defuseme/DefuseMe/doc/module/BigSwitch_4Lamps.docx

Big Switch – 4 Lamps

The module consists of a 3-position switch and
4 lamps lighting in orange and pink

Follow the flow chart:
The question rhomb asks if the specified lamp is lit.
The corresponding action box shows to which position the switch has to be rotated.

If all goes wrong, switch to position ‘0’ and start from top!

Lamps:
L-Pk = Left Pink Lamp
L-Or = Left Orange Lamp
R-Pk = Right Pink Lamp
R-Or = Right Orange Lamp
Switch: Note: switching fast
L = Left Pos. CCW from L->R or R->L
0 = Middle Pos. Don’t pause on ‘0’
R = Right Pos. CW

Defuseme.org BS4L V0.2 - JK
