defuseme/DefuseMe/module/BlueButtonStripe/design.ods

Sheet: snocode
Serial number digits |  |  |  | Number of BLUE BLINKING LEDs
1st | 2nd | 3rd | 4th to 15th | 0 | 1 | 2 | 3 | 4 | 5 | 6 | 7 | 8 | 9 | 10 | 11 | 12 | 13 | 14 | 15 | 16 | 17 | 18 | 19 | 20 | 21 | 22
0 | 0 | n.a. |  | 61 | 68 | 75 | 82 | 89 | 96 | 3 | 10 | 17 | 24 | 31 | 38 | 45 | 52 | 59 | 66 | 73 | 80 | 87 | 94 | 1 | 8 | 15 | 0
0 | 1 | n.a. |  | 85 | 92 | 99 | 6 | 13 | 20 | 27 | 34 | 41 | 48 | 55 | 62 | 69 | 76 | 83 | 90 | 97 | 4 | 11 | 18 | 25 | 32 | 39 | 1
0 | 2 | n.a. |  | 9 | 16 | 23 | 30 | 37 | 44 | 51 | 58 | 65 | 72 | 79 | 86 | 93 | 0 | 7 | 14 | 21 | 28 | 35 | 42 | 49 | 56 | 63 | 2
0 | 3 | n.a. |  | 33 | 40 | 47 | 54 | 61 | 68 | 75 | 82 | 89 | 96 | 3 | 10 | 17 | 24 | 31 | 38 | 45 | 52 | 59 | 66 | 73 | 80 | 87 | 3
0 | 4…7 | 0 | n.a. | 57 | 64 | 71 | 78 | 85 | 92 | 99 | 6 | 13 | 20 | 27 | 34 | 41 | 48 | 55 | 62 | 69 | 76 | 83 | 90 | 97 | 4 | 11 | 4
0 | 4…7 | not 0 | n.a. | 81 | 88 | 95 | 2 | 9 | 16 | 23 | 30 | 37 | 44 | 51 | 58 | 65 | 72 | 79 | 86 | 93 | 0 | 7 | 14 | 21 | 28 | 35 | 5
0 | 8…9 | n.a. |  | 5 | 12 | 19 | 26 | 33 | 40 | 47 | 54 | 61 | 68 | 75 | 82 | 89 | 96 | 3 | 10 | 17 | 24 | 31 | 38 | 45 | 52 | 59 | 6
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
