defuseme/DefuseMe/module/BigSwitch4Lamps/BigSwitchDesign.xlsx

Sheet: Design
Path | Step | L-Pk | L-Or | R-Pk | R-Or | Switch-L | Switch-R
0 | 0 |  | 1 |  | 1 | 1 |  | // 0
 | 1 |  | 1 | 1 |  |  | 1
 | 2 | 1 |  | 1
 | 3 |  | 1 |  | 1 | 1
 | 4 | 1 | 0 | 1 | 1 |  | 1
 | 5 | 0 | 1 | 1 |  | 0 | 0
 | 6
 | 7
 | 8
 | 9
1 | 0 |  | 1 |  | 1 | 1 |  | // 1
 | 1 | 1 |  | 0 | 1
 | 2 | 0 | 1 |  | 1 |  | 1
 | 3 | 0 | 1 | 1
 | 4 | 1 | 0 | 1 |  |  | 1
 | 5 | 0 | 1 | 1 |  | 0 | 0
 | 6
 | 7
 | 8
 | 9
2 | 0 |  | 1 | 1 |  | 1 |  | // 2
 | 1 |  | 1 | 0 | 1
 | 2 | 1 |  |  | 1 | 1
 | 3 | 1 |  | 1 | 0
 | 4 |  | 1 | 1 | 0 | 1
 | 5 | 0 | 1 |  | 1 |  | 1
 | 6 | 0 | 1 | 1 |  | 0 | 0
 | 7
 | 8
 | 9
3 | 0 | 1 | 0 | 1 |  |  | 1 | // 3
 | 1 |  | 1 | 1 | 0 | 1
 | 2 |  | 1 |  | 1 |  | 1
 | 3 | 1 | 0 |  | 1 | 1
 | 4 | 1 |  | 1
 | 5 |  | 1 | 1 | 0 | 1
 | 6 | 0 | 1 |  | 1 |  | 1
 | 7 | 0 | 1 | 1 |  | 0 | 0
 | 8
 | 9
4 | 0 |  | 1 | 1 |  | 1 |  | // 4
 | 1 |  | 1 | 0 | 1
 | 2 | 0 | 1 | 1 |  |  | 1
 | 3 | 1 |  | 1 |  | 1
 | 4 |  | 1 | 1 | 0
 | 5 | 1 | 0 | 1 |  |  | 1
 | 6 | 0 | 1 | 1 |  | 0 | 0
 | 7
 | 8
 | 9
5 | 0 |  | 1 |  | 1 | 1 |  | // 5
 | 1 |  | 1 | 1 |  |  | 1
 | 2 |  | 1 | 0 | 1 | 1
 | 3 | 1 |  |  | 1
 | 4 | 1 |  | 1 | 0 | 1
 | 5 | 0 | 1 | 1 |  |  | 1
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
