defuseme/DefuseMe/doc/module/ModuleScematics.pdf

# Overview

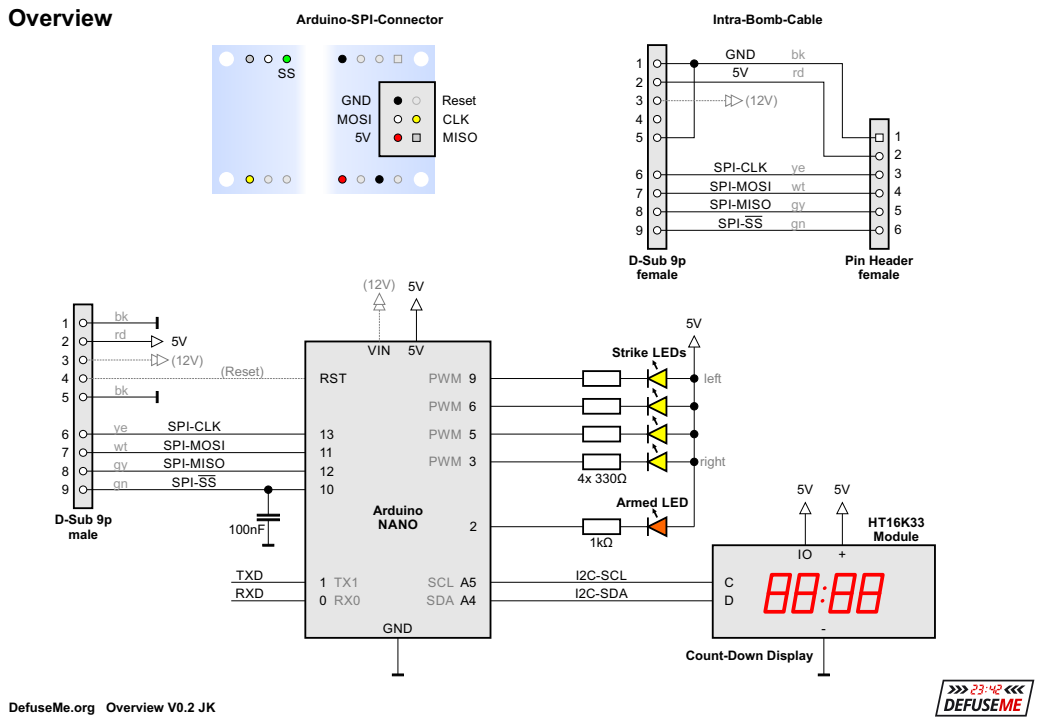
[picture p4: page 1]
SPI-SS; SPI-MISO; SPI-MOSI; SPI-CLK; RXD; TXD; I2C-SDA; I2C-SCL; SCL A5 SDA A4; GND; Arduino NANO; D-Sub 9p male; PWM 3; PWM 5; PWM 6; PWM 9; HT16K33 Module; Armed LED; VIN; MISO; CLK; MOSI; Reset; (Reset); D-Sub 9p female; Pin Header female; RST; Arduino-SPI-Connector; Intra-Bomb-Cable; Strike LEDs; left; right

Count-Down Display

DefuseMe.org Overview V0.2 JK
