defuseme/DefuseMe/lasercutter/Bomb01Combi2.pdf

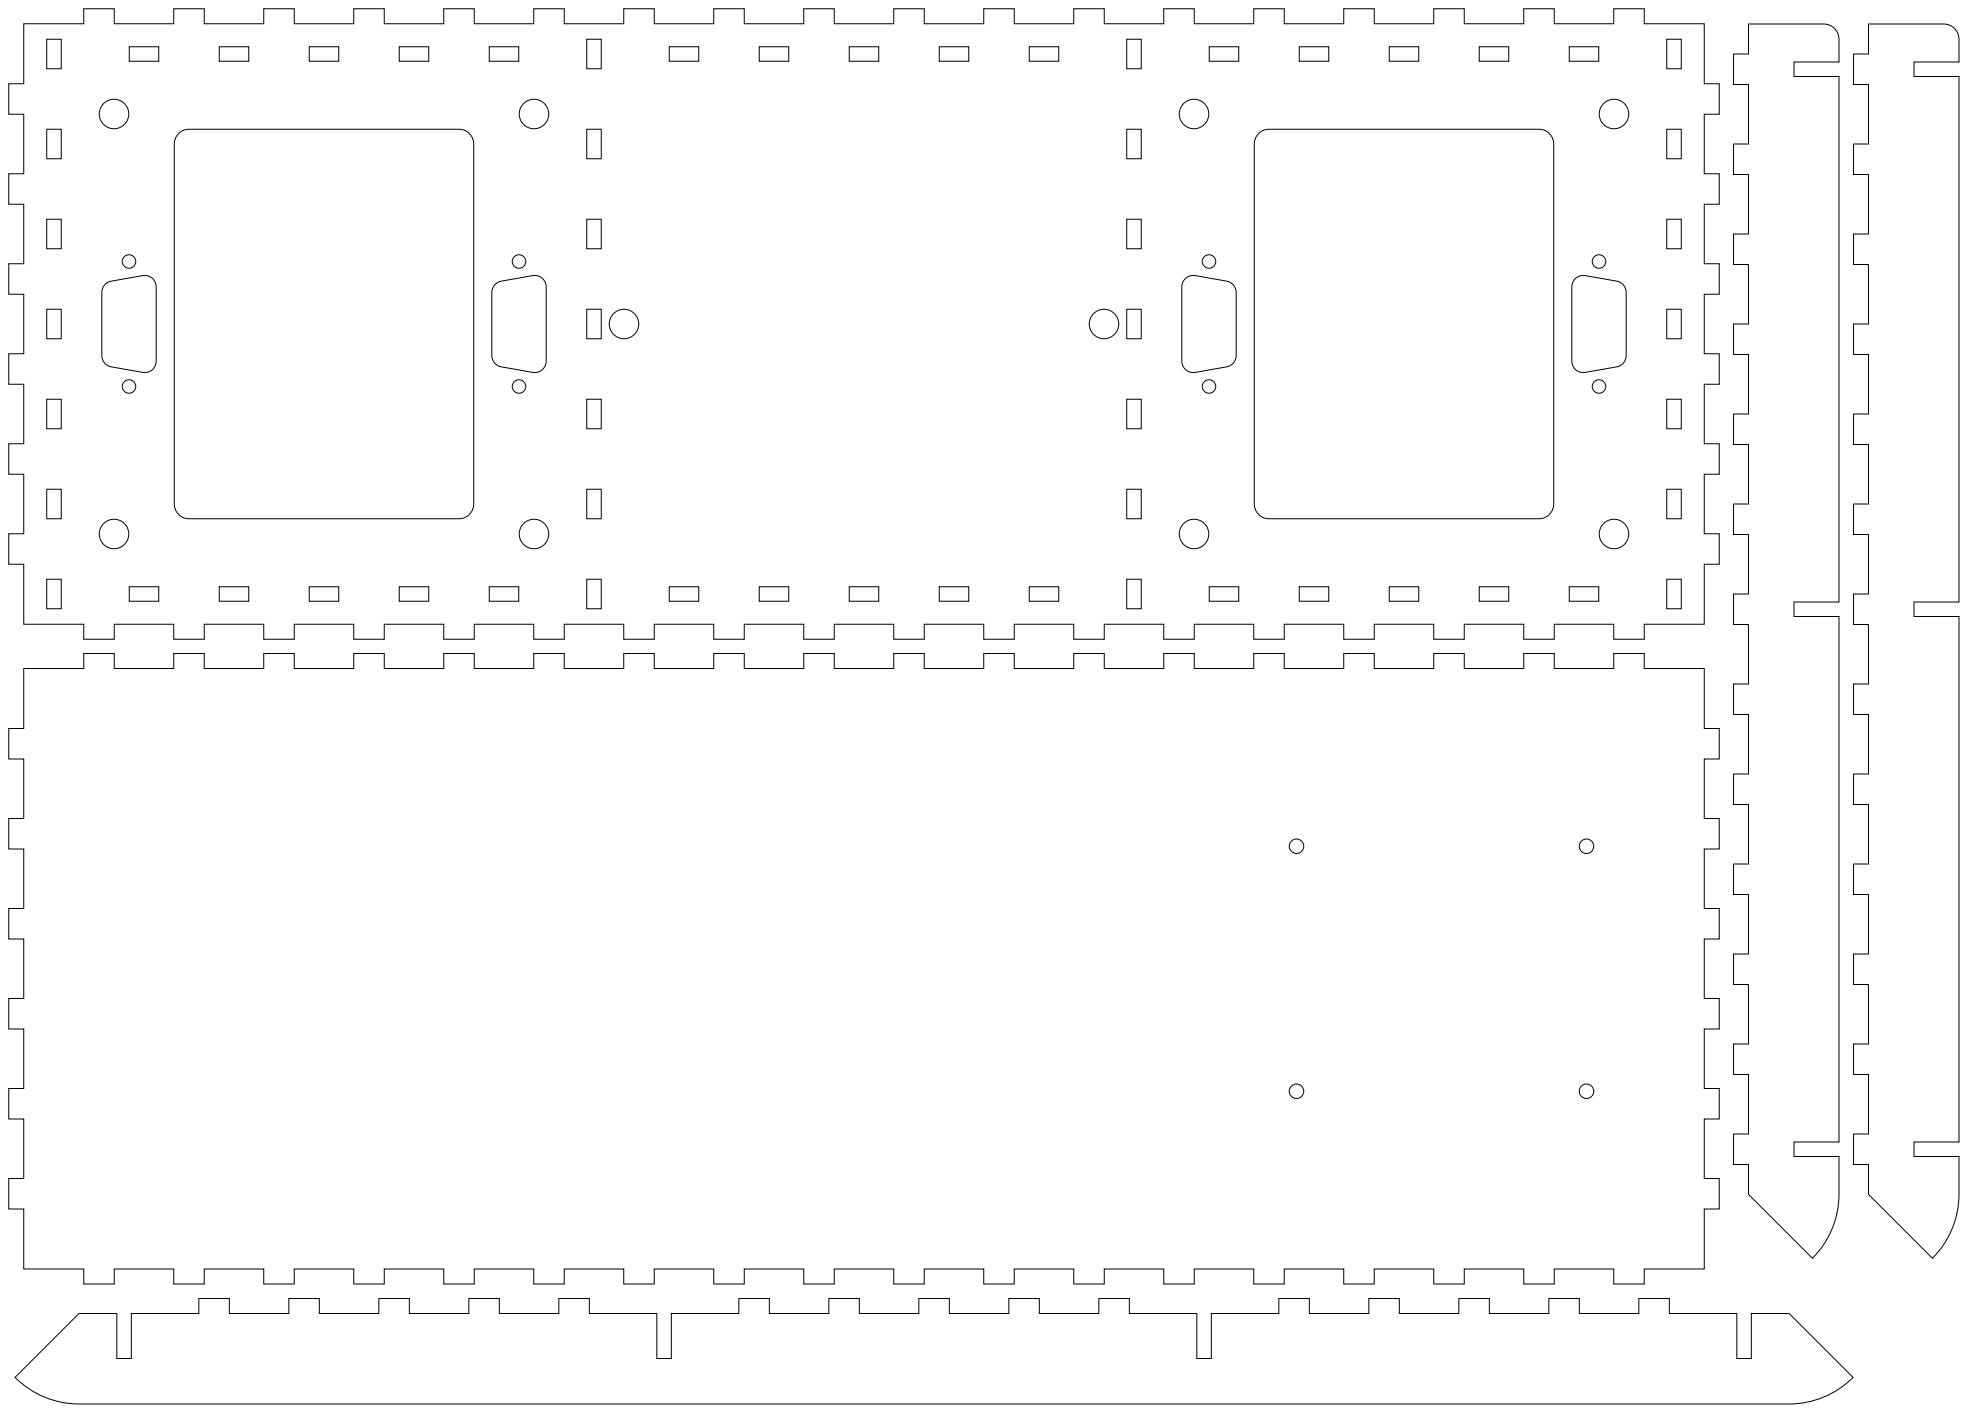
[picture p5: page 1]
