defuseme/DefuseMe/lasercutter/Bomb01Combi3.pdf

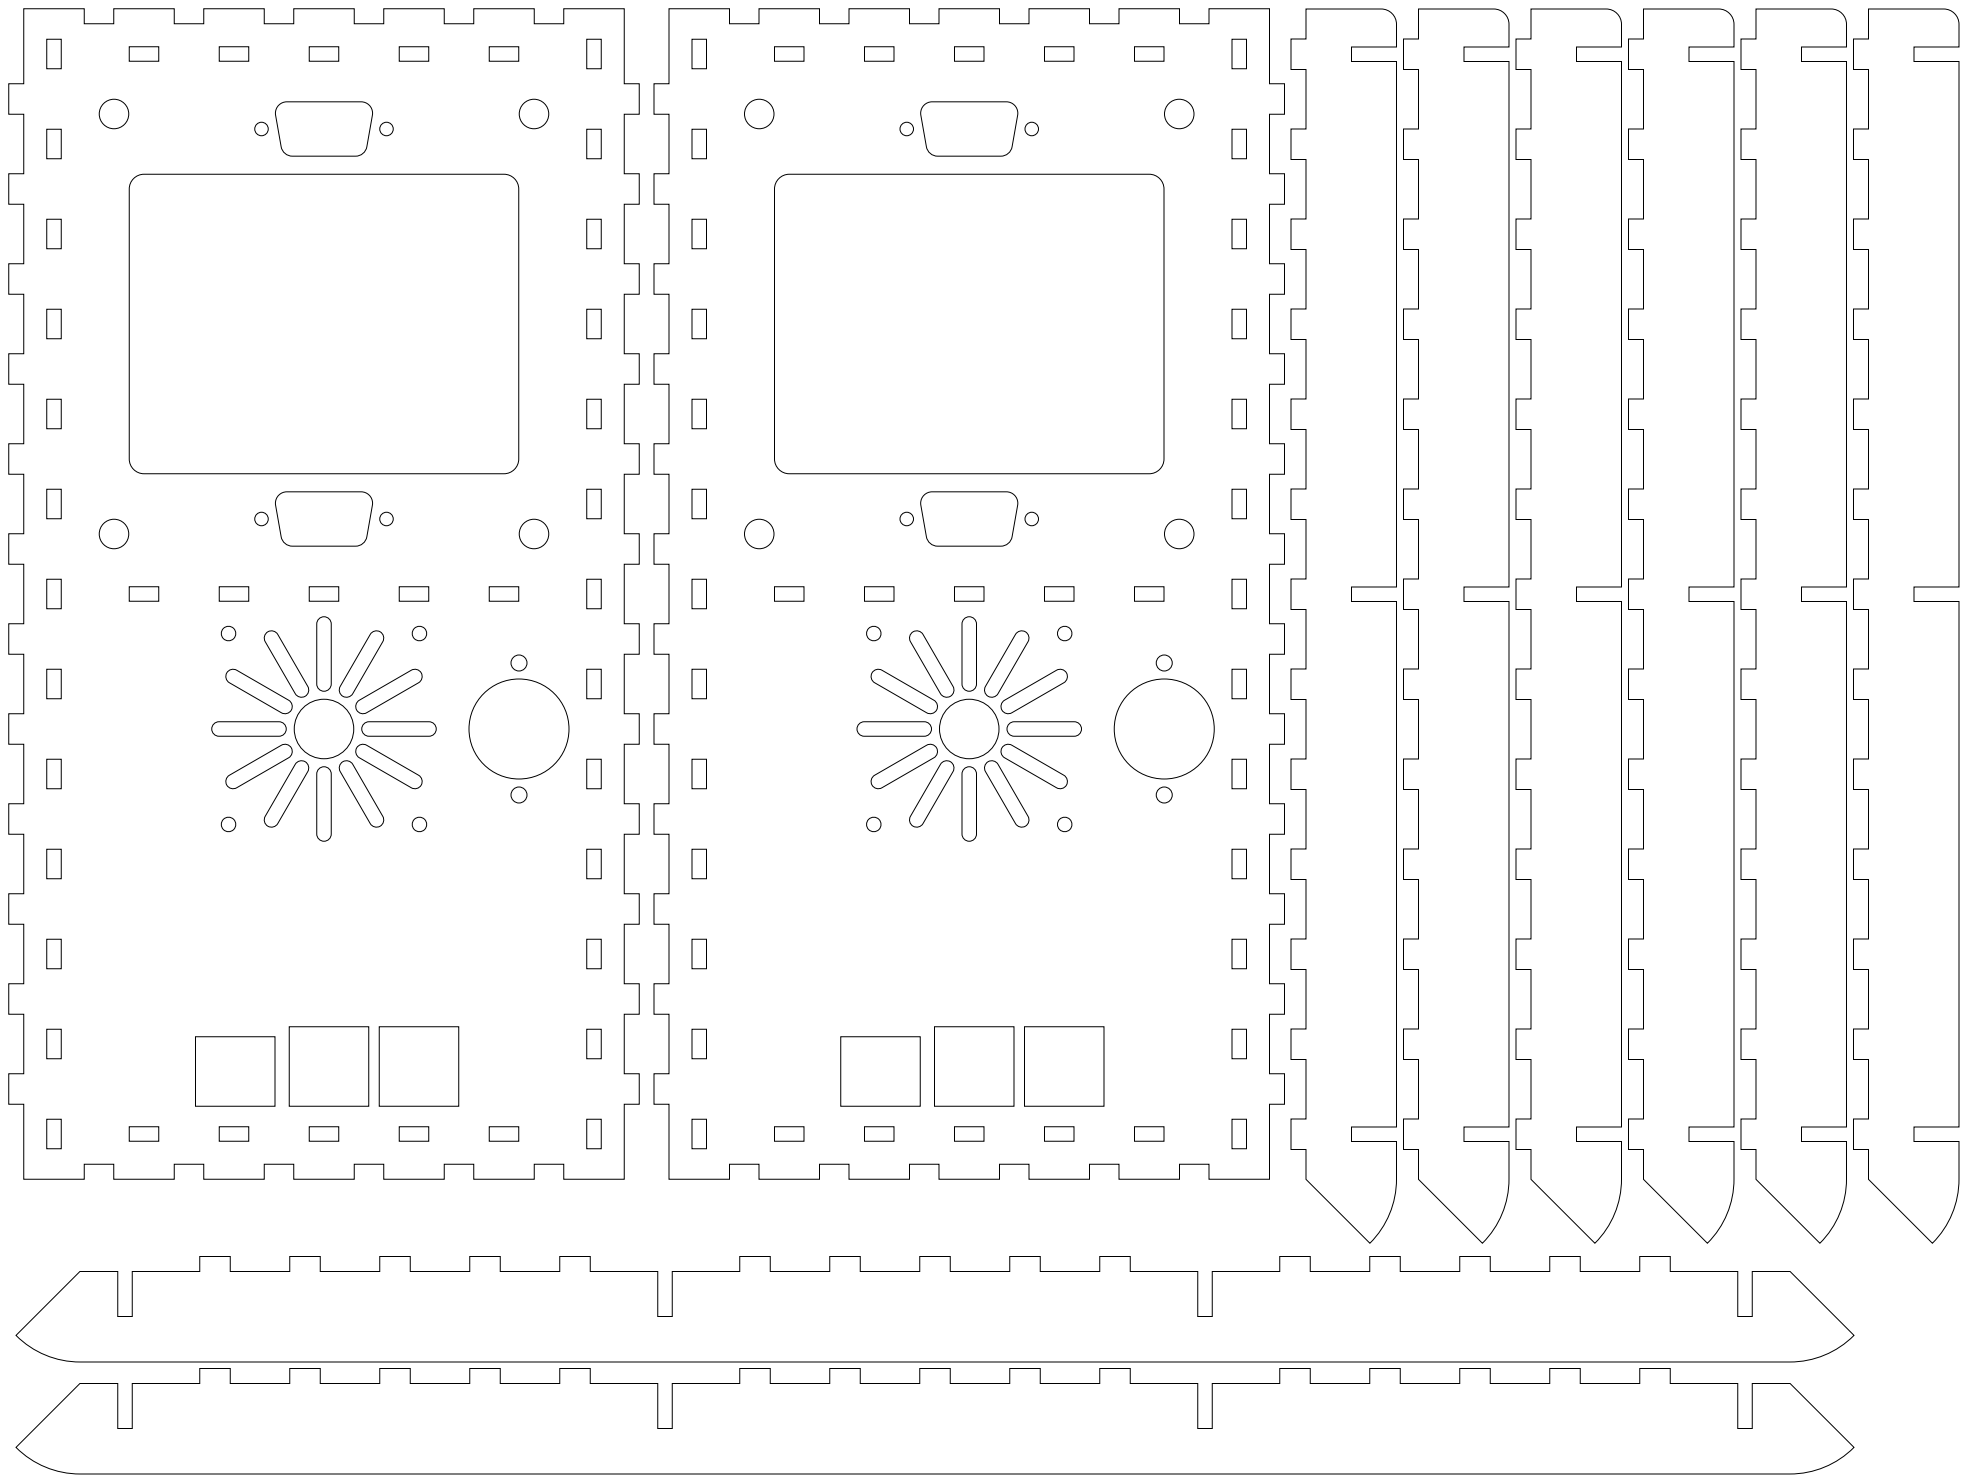
[picture p6: page 1]
