defuseme/DefuseMe/lasercutter/Bomb01Combi4.pdf

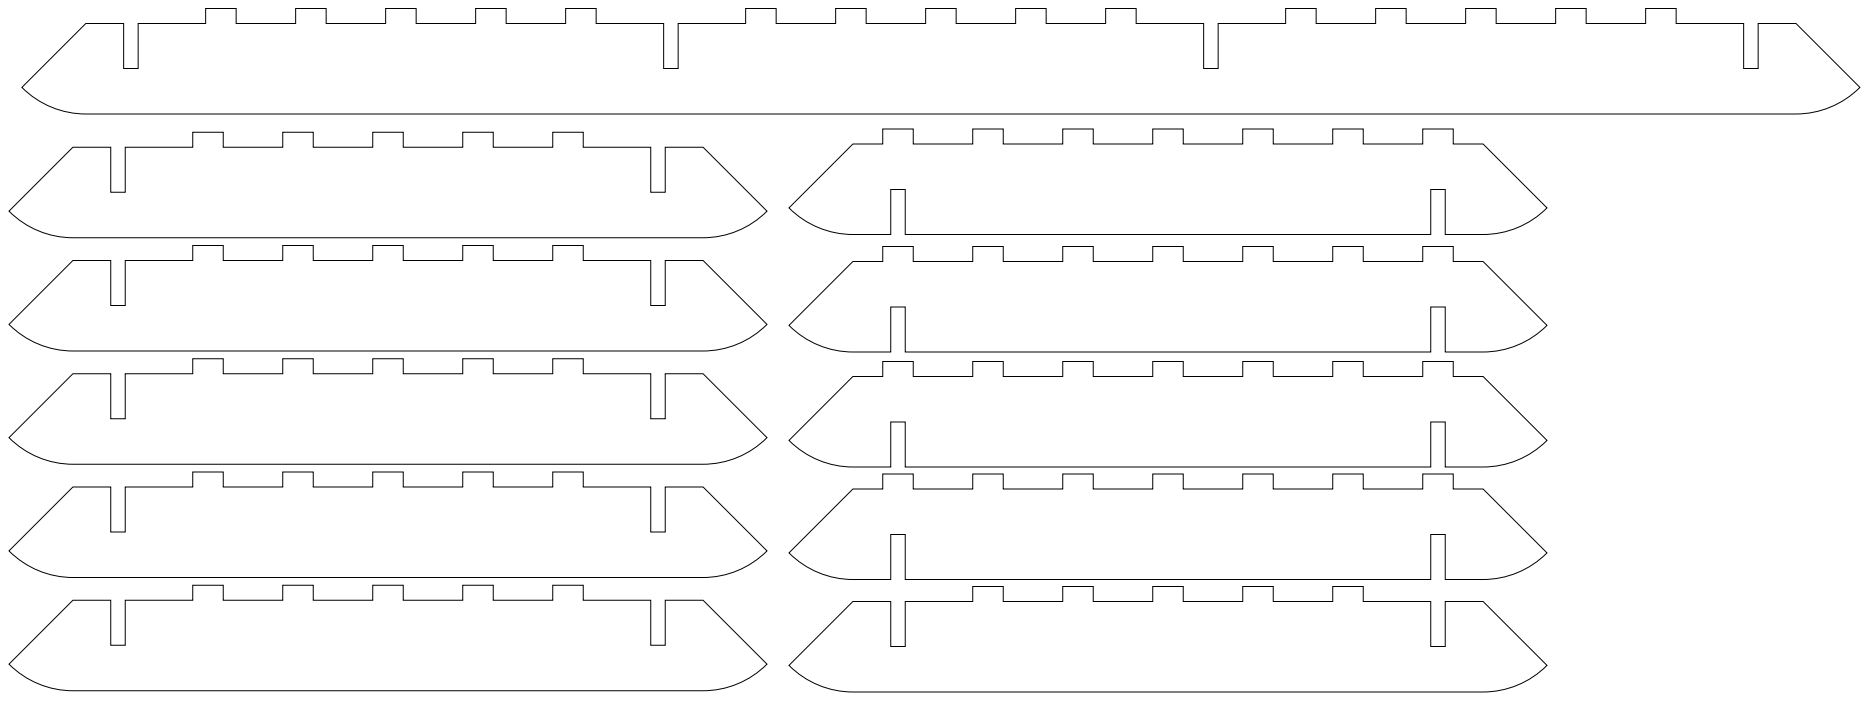
[picture p7: page 1]
