defuseme/DefuseMe/lasercutter/Bomb01MuduleBase.pdf

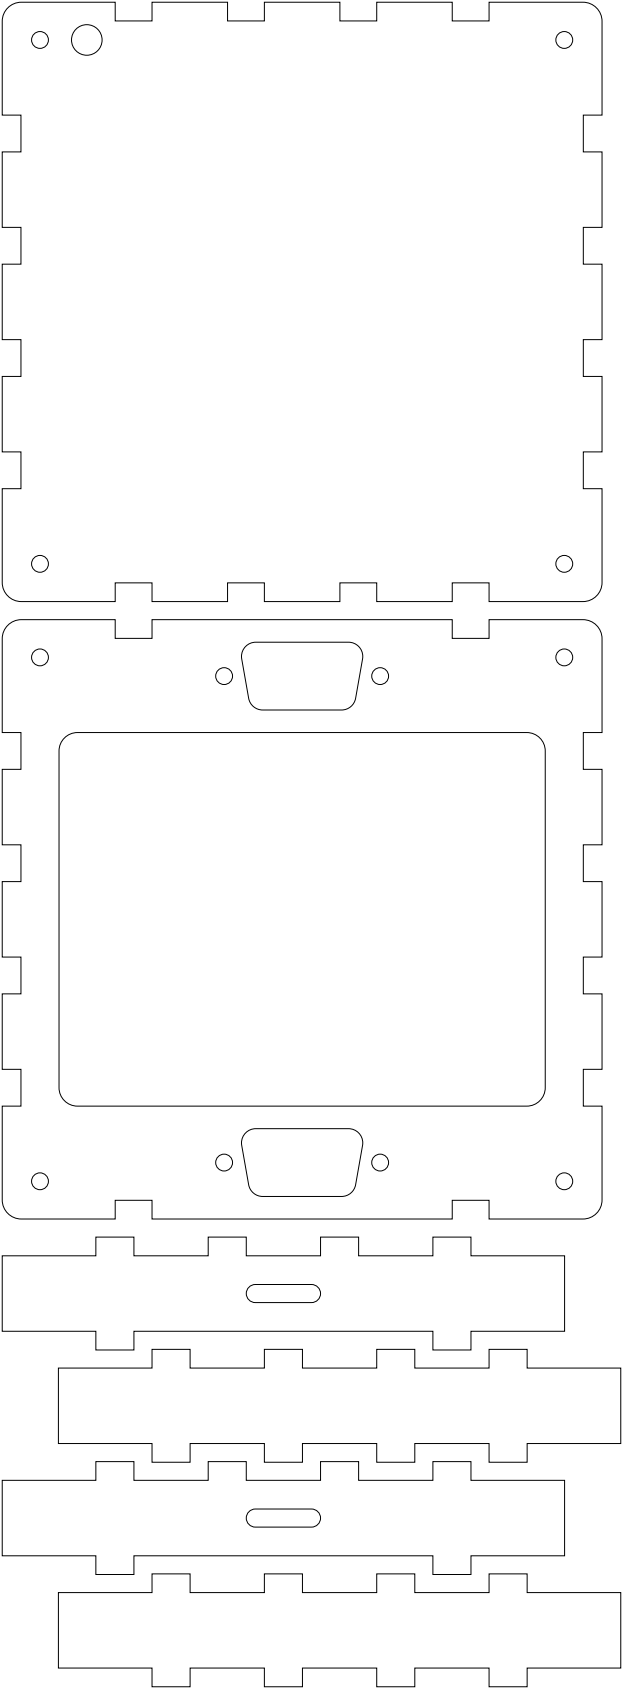
[picture p8: page 1]
