defuseme/DefuseMe/doc/module/BlueButtonStripe.pdf

## Blue Button - Stripe

## The module consists of a …

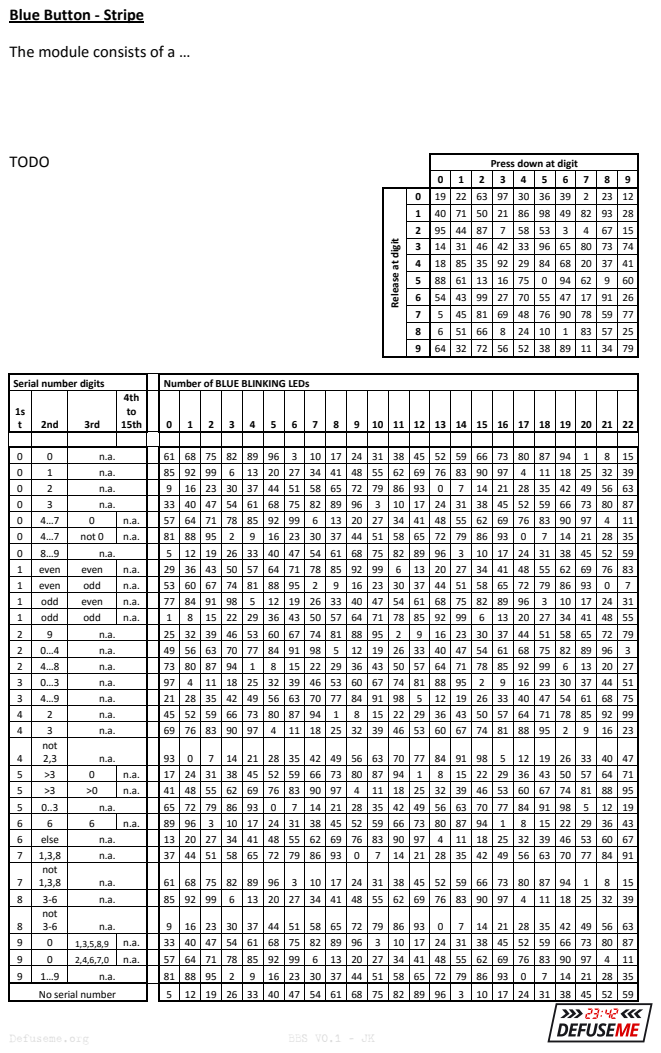
[picture p9: page 1]
Defuseme.org; BBS V0.1 - JK; TODO

Press down at digit

0 | 19 | 22 | 63 | 97 | 30 | 36 | 39 | 2 | 23 | 12
1 | 40 | 71 | 50 | 21 | 86 | 98 | 49 | 82 | 93 | 28
2 | 95 | 44 | 87 | 7 | 58 | 53 | 3 | 4 | 67 | 15
3 | 14 | 31 | 46 | 42 | 33 | 96 | 65 | 80 | 73 | 74
4 | 18 | 85 | 35 | 92 | 29 | 84 | 68 | 20 | 37 | 41
5 | 88 | 61 | 13 | 16 | 75 | 0 | 94 | 62 | 9 | 60
6 | 54 | 43 | 99 | 27 | 70 | 55 | 47 | 17 | 91 | 26
7 | 5 | 45 | 81 | 69 | 48 | 76 | 90 | 78 | 59 | 77
8 | 6 | 51 | 66 | 8 | 24 | 10 | 1 | 83 | 57 | 25
9 | 64 | 32 | 72 | 56 | 52 | 38 | 89 | 11 | 34 | 79

Release at digit

Serial number digits | | Number of BLUE BLINKING LEDs
1s t | 2nd | 3rd | 4th to 15th | 0 | 1 | 2 | 3 | 4 | 5 | 6 | 7 | 8 | 9 | 10 | 11 | 12 | 13 | 14 | 15 | 16 | 17 | 18 | 19 | 20 | 21 | 22

0 | 0 | n.a. | | 61 | 68 | 75 | 82 | 89 | 96 | 3 | 10 | 17 | 24 | 31 | 38 | 45 | 52 | 59 | 66 | 73 | 80 | 87 | 94 | 1 | 8 | 15
0 | 1 | n.a. | | 85 | 92 | 99 | 6 | 13 | 20 | 27 | 34 | 41 | 48 | 55 | 62 | 69 | 76 | 83 | 90 | 97 | 4 | 11 | 18 | 25 | 32 | 39
0 | 2 | n.a. | | 9 | 16 | 23 | 30 | 37 | 44 | 51 | 58 | 65 | 72 | 79 | 86 | 93 | 0 | 7 | 14 | 21 | 28 | 35 | 42 | 49 | 56 | 63
0 | 3 | n.a. | | 33 | 40 | 47 | 54 | 61 | 68 | 75 | 82 | 89 | 96 | 3 | 10 | 17 | 24 | 31 | 38 | 45 | 52 | 59 | 66 | 73 | 80 | 87
0 | 4…7 | 0 | n.a. | | 57 | 64 | 71 | 78 | 85 | 92 | 99 | 6 | 13 | 20 | 27 | 34 | 41 | 48 | 55 | 62 | 69 | 76 | 83 | 90 | 97 | 4 | 11
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
9 | 1…9 | n.a. | | | 81 | 88 | 95 | 2 | 9 | 16 | 23 | 30 | 37 | 44 | 51 | 58 | 65 | 72 | 79 | 86 | 93 | 0 | 7 | 14 | 21 | 28 | 35
No serial number | | | | | 5 | 12 | 19 | 26 | 33 | 40 | 47 | 54 | 61 | 68 | 75 | 82 | 89 | 96 | 3 | 10 | 17 | 24 | 31 | 38 | 45 | 52 | 59
