defuseme/DefuseMe/module/BigSwitch4Lamps/flowchart.pdf

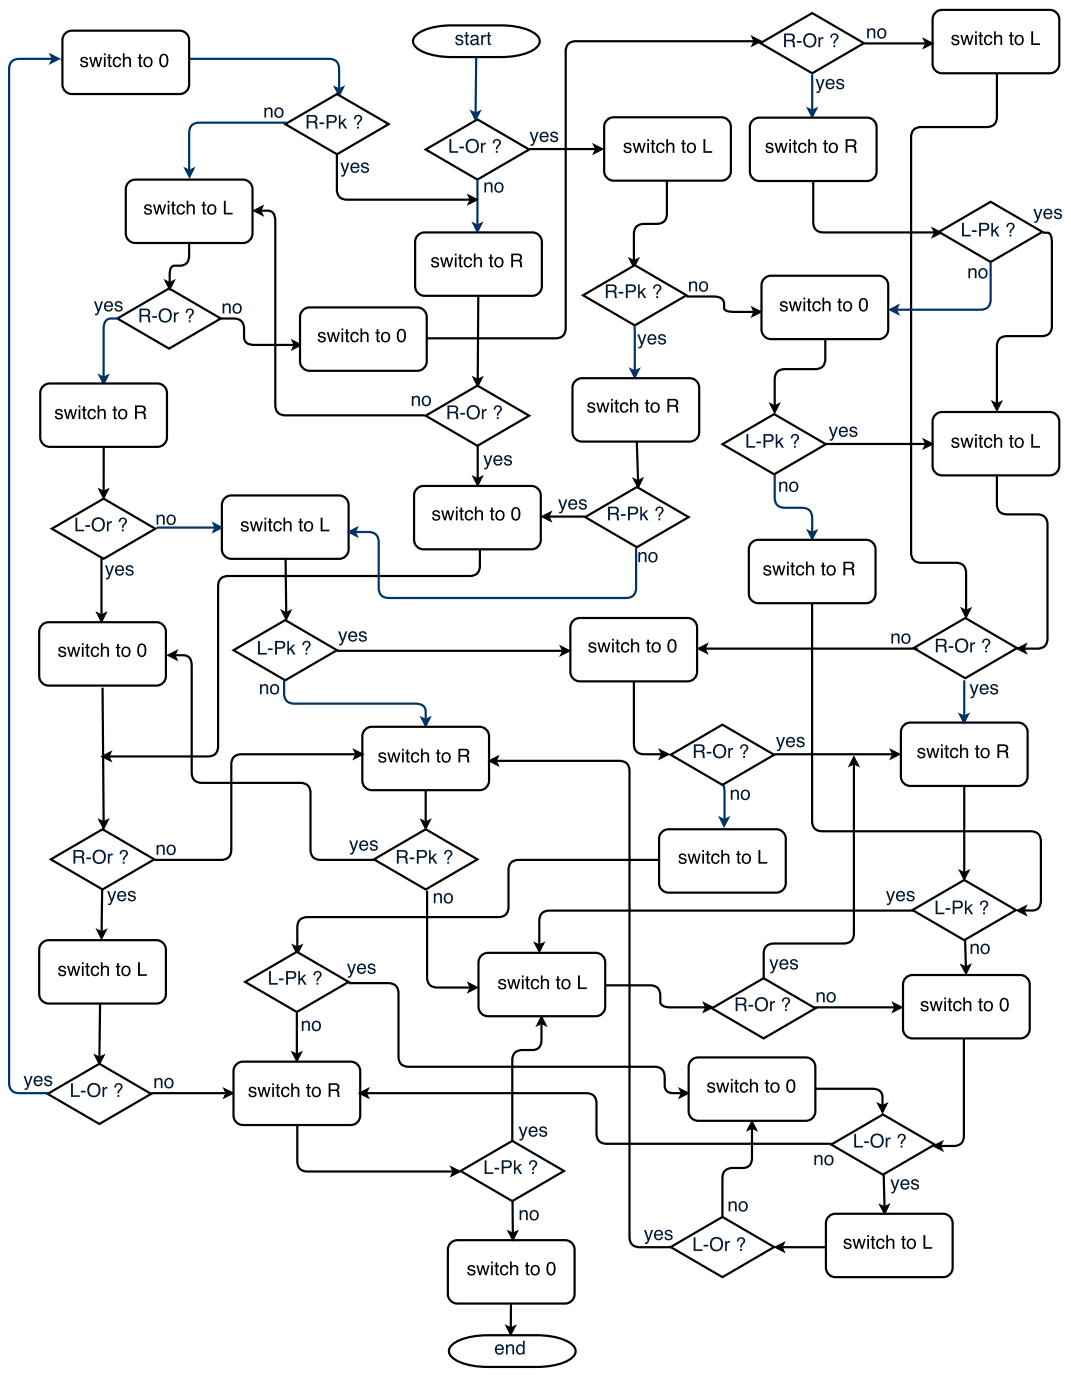
[picture p10: page 1]
