defuseme/DefuseMe/eagle/DefuseIt02.brd

## EAGLE design eagle/DefuseIt02.brd (2017-04-28)

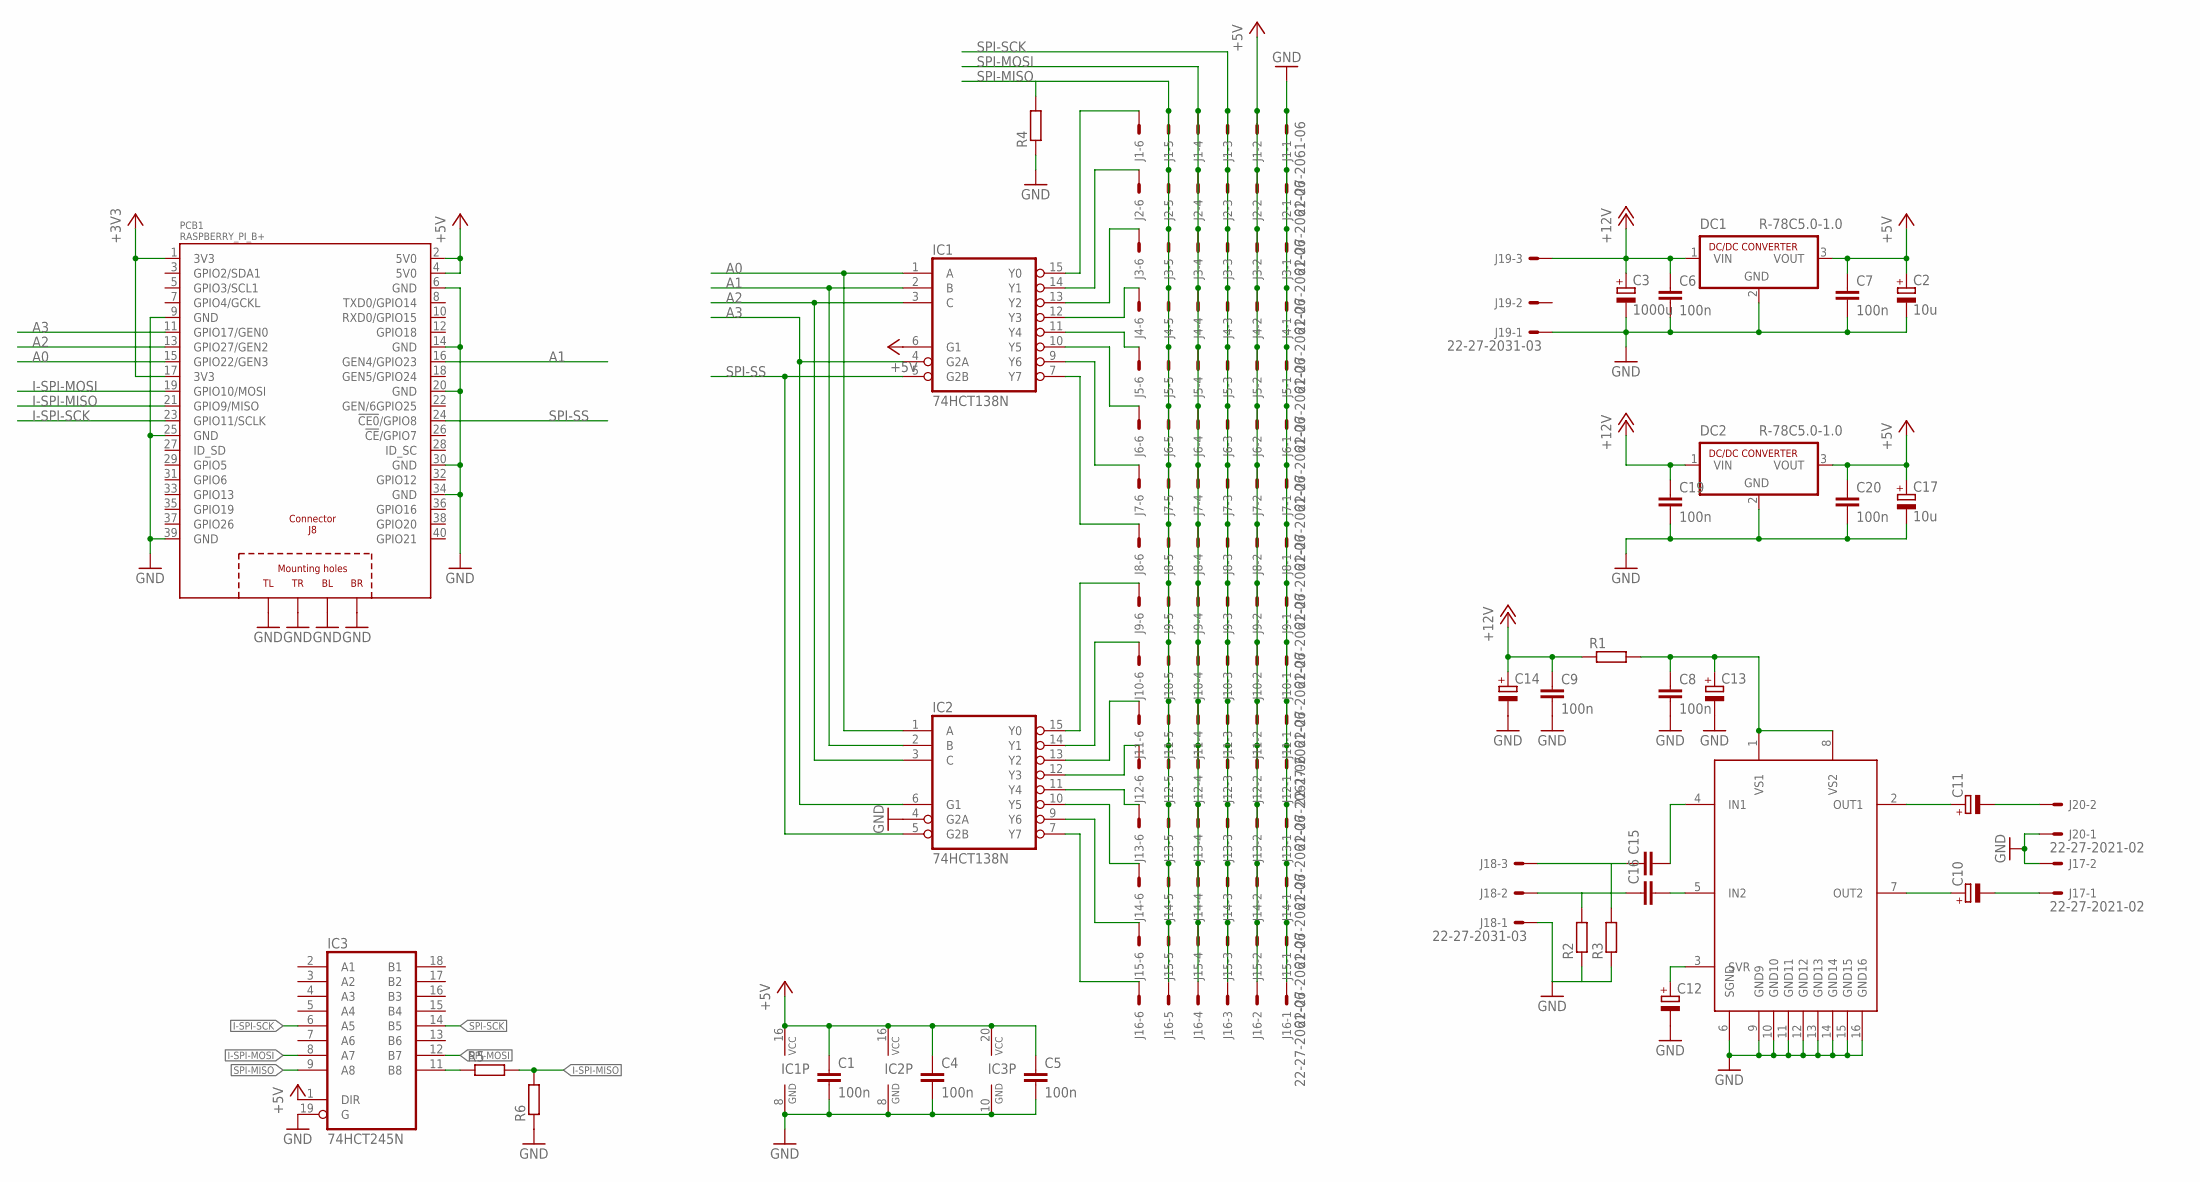
[picture p11: schematic DefuseIt02.sch]

Parts:
C1, C4, C5, C6, C7, C8, C9, C19, C20: 100n; C025-025X050
C2, C17: 10u; E3,5-8
C3: 1000u; E7,5-16
C10, C11: CPOL-EUE3.5-8; E3,5-8
C12, C13, C14: CPOL-EUE2.5-5; E2,5-5
C15, C16: C-EU050-030X075; C050-030X075
DC1, DC2: R-78C5.0-1.0; SIP3
IC1, IC2: 74HCT138N; DIL16
IC3: 74HCT245N; DIL20
J1, J2, J3, J4, J5, J6, J7, J8, J9, J10, J11, J12, J13, J14, J15, J16: 22-27-2061-06; 6410-06
J17, J20: 22-27-2021-02; 6410-02
J18, J19: 22-27-2031-03; 6410-03
PCB1: RASPBERRY_PI_B+
R1, R2, R3, R4, R5, R6: R-EU_0207/10; 0207/10
U$1: TDA7268; DIL16

Connections:
+3V3: PCB1.1 (3V3), PCB1.17 (3V3)
+5V: C1.1, C2.+, C4.1, C5.1, C7.1, DC1.3 (VOUT), IC1.6 (G1), IC1.16 (VCC), IC2.16 (VCC), IC3.1 (DIR), IC3.20 (VCC), J1.2, J2.2, J3.2, J4.2, J5.2, J6.2, J7.2, J8.2, J9.2, J10.2, J11.2, J12.2, J13.2, J14.2, J15.2, J16.2
+5VRPI: C17.+, C20.1, DC2.3 (VOUT), PCB1.2 (5V0), PCB1.4 (5V0)
+12V: C3.+, C6.1, C9.1, C14.+, C19.1, DC1.1 (VIN), DC2.1 (VIN), J19.3, R1.1
A0: IC1.1 (A), IC2.1 (A), PCB1.15 (GPIO22/GEN3)
A1: IC1.2 (B), IC2.2 (B), PCB1.16 (GEN4/GPIO23)
A2: IC1.3 (C), IC2.3 (C), PCB1.13 (GPIO27/GEN2)
A3: IC1.4 (G2A), IC2.6 (G1), PCB1.11 (GPIO17/GEN0)
GND: C1.2, C2.-, C3.-, C4.2, C5.2, C6.2, C7.2, C8.2, C9.2, C12.-, C13.-, C14.-, C17.-, C19.2, C20.2, DC1.2 (GND), DC2.2 (GND), IC1.8 (GND), IC2.4 (G2A), IC2.8 (GND), IC3.10 (GND), IC3.19 (G), J1.1, J2.1, J3.1, J4.1, J5.1, J6.1, J7.1, J8.1, J9.1, J10.1, J11.1, J12.1, J13.1, J14.1, J15.1, J16.1, J17.2, J18.1, J19.1, J20.1, PCB1.6 (GND), PCB1.9 (GND), PCB1.14 (GND), PCB1.20 (GND), PCB1.25 (GND), PCB1.30 (GND), PCB1.34 (GND), PCB1.39 (GND), PCB1.PE_BL (BL), PCB1.PE_BR (BR), PCB1.PE_TL (TL), PCB1.PE_TR (TR), R2.1, R3.1, R4.1, R6.1, U$1.6 (SGND), U$1.9 (GND9), U$1.10 (GND10), U$1.11 (GND11), U$1.12 (GND12), U$1.13 (GND13), U$1.14 (GND14), U$1.15 (GND15), U$1.16 (GND16)
I-SPI-MISO: PCB1.21 (GPIO9/MISO), R5.2, R6.2
I-SPI-MOSI: IC3.8 (A7), PCB1.19 (GPIO10/MOSI)
I-SPI-SCK: IC3.6 (A5), PCB1.23 (GPIO11/SCLK)
unnamed: IC1.12 (Y3), J4.6
unnamed: IC1.11 (Y4), J5.6
unnamed: IC1.13 (Y2), J3.6
unnamed: IC1.14 (Y1), J2.6
unnamed: IC1.15 (Y0), J1.6
unnamed: IC1.10 (Y5), J6.6
unnamed: IC1.9 (Y6), J7.6
unnamed: IC1.7 (Y7), J8.6
unnamed: IC2.12 (Y3), J12.6
unnamed: IC2.11 (Y4), J13.6
unnamed: IC2.13 (Y2), J11.6
unnamed: IC2.14 (Y1), J10.6
unnamed: IC2.15 (Y0), J9.6
unnamed: IC2.10 (Y5), J14.6
unnamed: IC2.9 (Y6), J15.6
unnamed: IC2.7 (Y7), J16.6
unnamed: C16.2, U$1.5 (IN2)
unnamed: C12.+, U$1.3 (SVR)
unnamed: C10.+, U$1.7 (OUT2)
unnamed: C11.+, U$1.2 (OUT1)
unnamed: C11.-, J20.2
unnamed: C10.-, J17.1
unnamed: C8.1, C13.+, R1.2, U$1.1 (VS1), U$1.8 (VS2)
unnamed: IC3.11 (B8), R5.1
unnamed: C15.2, U$1.4 (IN1)
unnamed: C16.1, J18.2, R2.2
unnamed: C15.1, J18.3, R3.2
SPI-MISO: IC3.9 (A8), J1.5, J2.5, J3.5, J4.5, J5.5, J6.5, J7.5, J8.5, J9.5, J10.5, J11.5, J12.5, J13.5, J14.5, J15.5, J16.5, R4.2
SPI-MOSI: IC3.12 (B7), J1.4, J2.4, J3.4, J4.4, J5.4, J6.4, J7.4, J8.4, J9.4, J10.4, J11.4, J12.4, J13.4, J14.4, J15.4, J16.4
SPI-SCK: IC3.14 (B5), J1.3, J2.3, J3.3, J4.3, J5.3, J6.3, J7.3, J8.3, J9.3, J10.3, J11.3, J12.3, J13.3, J14.3, J15.3, J16.3
SPI-SS: IC1.5 (G2B), IC2.5 (G2B), PCB1.24 (!CE0!/GPIO8)

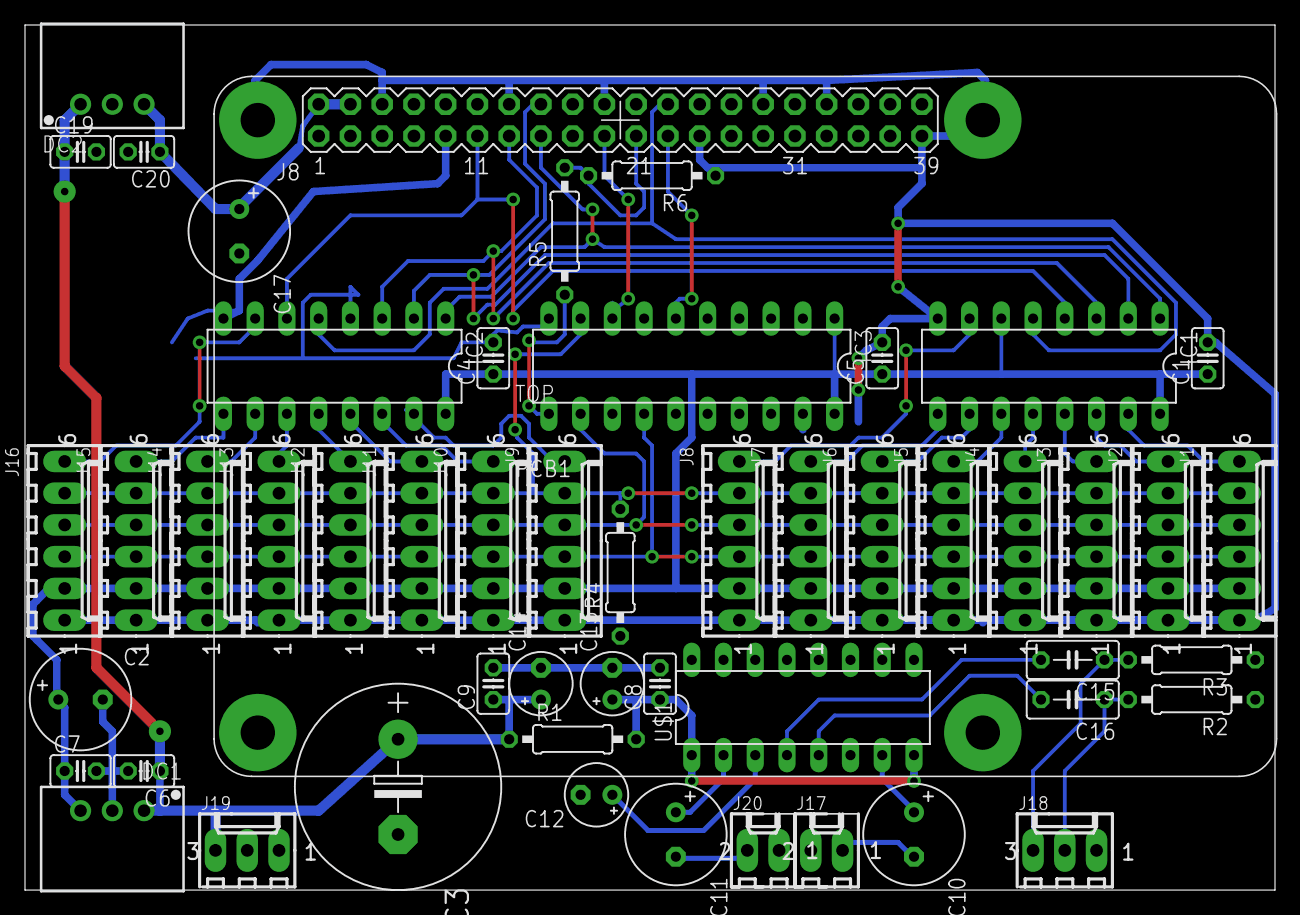
[picture p12: board DefuseIt02.brd from above]

Board: 2 copper layers, 100.0 x 69.2 mm, 52 parts (0 on the bottom side), 43 nets.
