defuseme/DefuseMe/module/BigSwitch4Lamps/BigSwitch4Lamps.ino

#include "pins_arduino.h"
#include "DefuseMe.h"
#include "MultiSwitch.h"
#include "LED.h"
#include "StateMachine.h"

struct STATES {
  byte lamps;
  byte switchpos;
};

// Generated wit Excel sheet BigSwitch.xlsx - do not change manually
// Lamps: 1=L-Pk 2=L-Or 4=R-Pk 8=R-Or   Switch: 0=0 L=1 R=2
STATES states[10][10] = {
  10  , 1 , // 0
  6 , 2 ,
  5 , 0 ,
  10  , 1 ,
  13  , 2 ,
  6 , 0 ,
  0 , 0 ,
  0 , 0 ,
  0 , 0 ,
  0 , 0 ,
  10  , 1 , // 1
  9 , 0 ,
  10  , 2 ,
  6 , 0 ,
  5 , 2 ,
  6 , 0 ,
  0 , 0 ,
  0 , 0 ,
  0 , 0 ,
  0 , 0 ,
  6 , 1 , // 2
  10  , 0 ,
  9 , 1 ,
  5 , 0 ,
  6 , 1 ,
  10  , 2 ,
  6 , 0 ,
  0 , 0 ,
  0 , 0 ,
  0 , 0 ,
  5 , 2 , // 3
  6 , 1 ,
  10  , 2 ,
  9 , 1 ,
  5 , 0 ,
  6 , 1 ,
  10  , 2 ,
  6 , 0 ,
  0 , 0 ,
  0 , 0 ,
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
};

///////////////////////////////////////////////////////////////////////////////

class StateMachineBS : public StateMachine
{
  public:
    enum EState : byte {
      S_Init = 0,   // Init must be 0 for base class initialisation and watchdog
      S_Wait4Switch0,
      S_SetLED,
      S_Wait4SwitchChange,
      S_BOOM,
      S_BOOM_0,
      S_BOOM_1,
      S_Disarmed,
      S_Wait4Godot,
    };

  protected:
    byte _blink;
    byte _step;
    byte _variant;
    int _updateLED;

    virtual byte DoProcessInternal();
};

///////////////////////////////////////////////////////////////////////////////

DefuseMeModule module;
StateMachineBS engine;
LED gameLED[4] { (9), (6), (5), (3) };   // L-Pk, L-Or, R-Pk, R-Or
LED armedLED(2);
MultiSwitch multiswitch(A0, A1);   // L, R to GND

///////////////////////////////////////////////////////////////////////////////

void setup (void)
{
  Serial.begin (115200);
  Serial.println(F("Big Switch"));

  // init the module engine with SPI and random seed
  module.begin();

  //The Values we want to send out to our neighbours
  tag *ourtags = new tag[3] {
    tag(F("ACTIVE"), "true"), //active module =>user interaction possible
    tag(F("SWITCH"), "1"), //1 switch
    tag(F("LED"), "4"), //4 gameLEDs
  };

  //creates the module description and waits for the bomb controller to send the broadcasts of the other members and start the game
  module.waitForInit(NULL, 0, F("ID:0104\n"
                                "VERSION:0.0\n"
                                "URL:https://defuseme.org/\n"
                                "AUTHOR:JK\n"
                                "DESC:Bif Switch - 4 Lamps - AT WORK\n"
                                "REPO:https://github.com/defuseme/DefuseMe\n"),
                     ourtags, 3);

  // those are not needed anymore
  delete ourtags;
}

///////////////////////////////////////////////////////////////////////////////

void loop (void)
{
  if (module.updateState())
  {
    engine.SetGameState(module.getGameState());
  }

  multiswitch.DoProcess();
  engine.DoProcess();
}

///////////////////////////////////////////////////////////////////////////////

byte StateMachineBS::DoProcessInternal()
{
  byte mask = 1;

  switch (_eState)
  {

    // S_Init - initialize state machine. Also calgameLED on reentry from watchdog

    default:
    case S_Init:
      Serial.println(F("S_Init"));
      WatchDog(0);   // reset watchdog
      armedLED = 1;
      module.setMyState(1);   // armed
      _step = 0;
      _variant = random(10);
      Serial.print(F("Variant: "));
      Serial.println(_variant);
      return S_Wait4Switch0;

    // S_WaitSwitch0 - Blink till the user/admin set the switch to '0'

    case S_Wait4Switch0:
      if (multiswitch == 0)
        return S_SetLED;

      _blink = !_blink;
      for (byte i = 0; i < 4; i++)
        gameLED[i] = _blink;
      DelayNext(100);   // flicker with 5Hz
      break;   // stay in this state

    case S_SetLED:
      Serial.print(F("S_SetLED - "));
      Serial.println();
      for (byte i = 0; i < 4; i++)
      {
        if (states[_variant][_step].lamps & mask)
        {
          gameLED[i] = (random(23) != 0);
        }
        else
        {
          gameLED[i] = (random(123) == 0);   // flicker short time
          gameLED[i] = 0;
        }
        Serial.print(states[_variant][_step].lamps & mask);
        mask <<= 1;
      }

      return S_Wait4SwitchChange;

    // S_ButtonPressed - action at button was pressed

    case S_Wait4SwitchChange:
      if (! multiswitch.IsChanged())
      {
        if ((++_updateLED) > 42)
        {
          _updateLED = 0;
          return S_SetLED;
        }
        return S_Wait4SwitchChange;
      }

      Serial.print(F("S_Wait4SwitchChange - changed to "));
      Serial.println(multiswitch);

      if (multiswitch == states[_variant][_step].switchpos)
      {
        _step++;
        if (states[_variant][_step].lamps == 0)
          return S_Disarmed;

        return S_SetLED;
      }
      return S_BOOM;

    // S_BOOM - set bomb to triggered. Forces a strike and come back to armed state

    case S_BOOM:
      Serial.println(F("S_BOOM"));
      module.trigger();   // triger produces a strike on each call
      WatchDog(1000);   // reset state machine after 2sec flickering
      return S_BOOM_0;

    case S_BOOM_0:
      armedLED = 1;
      for (byte i = 0; i < 4; i++)
        gameLED[i] = (random(3) == 0);
      DelayNext(50);   // flicker with 10Hz
      return S_BOOM_1;   // endless loop - ended by watchdog

    case S_BOOM_1:
      armedLED = 0;
      for (byte i = 0; i < 4; i++)
        gameLED[i] = (random(3) == 0);
      DelayNext(50);   // flicker with 10Hz
      return S_BOOM_0;   // endless loop - ended by watchdog

    // S_Disarmed - set bomb to disarmed and be quiet

    case S_Disarmed:
      Serial.println(F("S_Disarmed"));
      module.setMyState(0);   // set bomb to disarmed
      armedLED = 0;
      for (byte i = 0; i < 4; i++)
        gameLED[i] = 0;
      return S_Wait4Godot;

    // S_Wait4Godot - wait forever (until button pressed again)

    case S_Wait4Godot:
      if (multiswitch)   // want to touch a disarmed module? OK!?! As you wish!!!
        return S_BOOM;
      break;
  }

  return _eState;   // no state change - repeat actual state
}
