defuseme/DefuseMe/module/_Demo_Test_/LEDdemo/LEDdemo.ino

#include "LED.h"

LED x(13);

long aMatrix[10][32][8] =
{
  4	,	6	,	10	,	10	,	12	,	2	,	12	,	4	,
  5	,	7	,	8	,	6	,	9	,	6	,	11	,	13	,
  3	,	29	,	2	,	9	,	2	,	13	,	6	,	9	,
  6	,	15	,	8	,	4	,	6	,	9	,	5	,	4	,
  1	,	7	,	10	,	9	,	7	,	12	,	35	,	9	,
  6	,	9	,	2	,	12	,	1	,	5	,	6	,	8	,
  5	,	6	,	10	,	13	,	6	,	15	,	11	,	12	,
  3	,	11	,	8	,	3	,	9	,	1	,	2	,	9	,

  4	,	6	,	10	,	10	,	12	,	2	,	12	,	4	,
  5	,	7	,	8	,	6	,	9	,	6	,	11	,	13	,
  3	,	29	,	2	,	9	,	2	,	13	,	6	,	9	,
  6	,	15	,	8	,	4	,	6	,	9	,	5	,	4	,
  1	,	7	,	10	,	9	,	7	,	12	,	35	,	9	,
  6	,	9	,	2	,	12	,	1	,	5	,	6	,	8	,
  5	,	6	,	10	,	13	,	6	,	15	,	11	,	12	,
  3	,	11	,	8	,	3	,	9	,	1	,	2	,	9	,

  4	,	6	,	10	,	10	,	12	,	2	,	12	,	4	,
  5	,	7	,	8	,	6	,	9	,	6	,	11	,	13	,
  3	,	29	,	2	,	9	,	2	,	13	,	6	,	9	,
  6	,	15	,	8	,	4	,	6	,	9	,	5	,	4	,
  1	,	7	,	10	,	9	,	7	,	12	,	35	,	9	,
  6	,	9	,	2	,	12	,	1	,	5	,	6	,	8	,
  5	,	6	,	10	,	13	,	6	,	15	,	11	,	12	,
  3	,	11	,	8	,	3	,	9	,	1	,	2	,	9	,

  4	,	6	,	10	,	10	,	12	,	2	,	12	,	4	,
  5	,	7	,	8	,	6	,	9	,	6	,	11	,	13	,
  3	,	29	,	2	,	9	,	2	,	13	,	6	,	9	,
  6	,	15	,	8	,	4	,	6	,	9	,	5	,	4	,
  1	,	7	,	10	,	9	,	7	,	12	,	35	,	9	,
  6	,	9	,	2	,	12	,	1	,	5	,	6	,	8	,
  5	,	6	,	10	,	13	,	6	,	15	,	11	,	12	,
  3	,	11	,	8	,	3	,	9	,	1	,	2	,	9
};

void setup() {
  // put your setup code here, to run once:

}

void loop() {
  // put your main code here, to run repeatedly:
  x.on();
  delay(1000);
  x.off();
  delay(200);
  x.set(1);
  delay(1000);
  x = 0;
  delay(200);

  for (byte i = 0; i <= 255; i++)
  {
    x.dim(i);
    delay(20);
  }

  for (byte y = 0; y < 8; y++)
    for (byte x = 0; x < 8; x++)
    {
      byte a = aMatrix[0][y][x];
      aMatrix[1][y][x] = aMatrix[0][y][x];
      x = a + aMatrix[2][y][x];
      Serial.println (aMatrix[1][y][x]);
    }
}
