defuseme/DefuseMe/(commit log)

2015-12-09 added eagle subfolder
    [DefuseIt01.brd, DefuseIt01.sch]
2015-12-10 Finished first layout w/o audio
    [DefuseIt01.brd, DefuseIt01.sch]
2015-12-20 added audio chip; layout correction
    [DefuseIt01.brd, DefuseIt01.sch]
2016-01-01 Added protocoll command codes
    [protocoll_codes.ods]
2016-01-01 Prepared test cases and protocoll encoder
2016-09-04 MRMCD Overall Commit
    [protocoll_codes.ods]
2016-11-05 First contact to a new world (arduino) via SPI
2016-11-05 Added to SPI dedicated test files
2016-12-15 Added first draft of module lib and samples
    [dmMatrix.xlsx]
2016-12-19 added serial number generator and printer
2016-12-19 Finished firmware and paper inlays
    [DefuseMeSNO.xlsx]
2016-12-21 Added module BigSwitch4Lamps
    [BigSwitchDesign.xlsx]
2016-12-21 case sensitive names
2016-12-21 added REGISTER field, added status, added access by slot
2016-12-22 work release
    [BigSwitchDesign.xlsx]
2016-12-23 fixed flow chart bug - rework doc
    [BigSwitchDesign.xlsx]
2016-12-24 Added module Blue Button Stripe - work release
2016-12-28 added flickering to LEDs
2016-12-31 moved module source code 1 folder down
    [BigSwitchDesign.xlsx, DefuseMeSNO.xlsx, design.ods, dmMatrix.xlsx]
2017-01-02 rework of pin array lib
    [PinArrayTest.ino, PlugArray4x4.ino]
2017-01-05 documentation / laser cut files
    [design.ods]
